briandorey/RaspberryPiBarcodeScanner/README.md

# Raspberry Pi Zero W Barcode Scanner
Raspberry Pi Zero W based barcode scanner files for http://www.briandorey.com/post/Raspberry-Pi-Zero-Handheld-Barcode-Scanner-Part-3
