briandorey/RaspberryPiBarcodeScanner/front lens.dxf

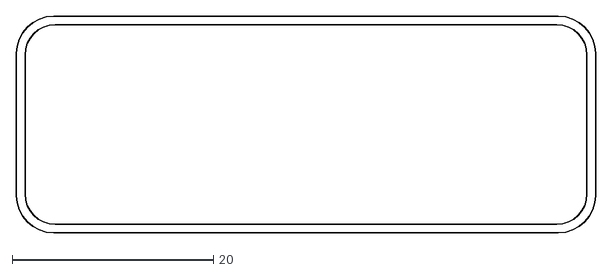
[picture p1: CAD file, 2017-06-02]
front lens.dxf
57.5 x 21.5
