briandorey/RaspberryPiBarcodeScanner/Interface-Board.pdf

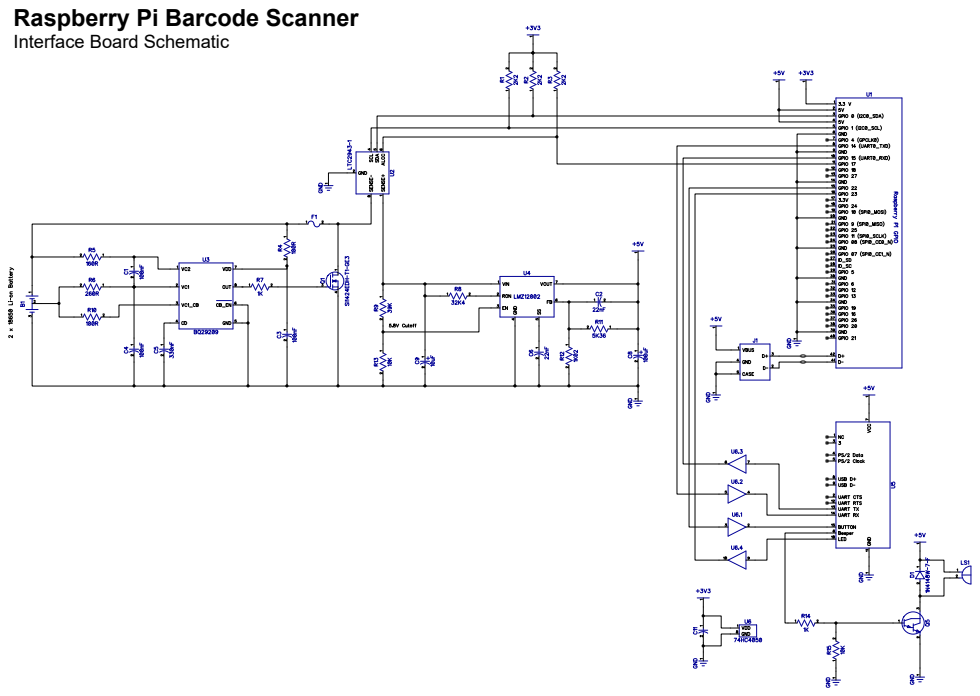
[picture p2: page 1]

Raspberry Pi Barcode Scanner
Interface Board Schematic
