briandorey/RaspberryPiBarcodeScanner/Software-Flowchart.pdf

# Raspberry Pi Barcode Scanner

# Software Flow

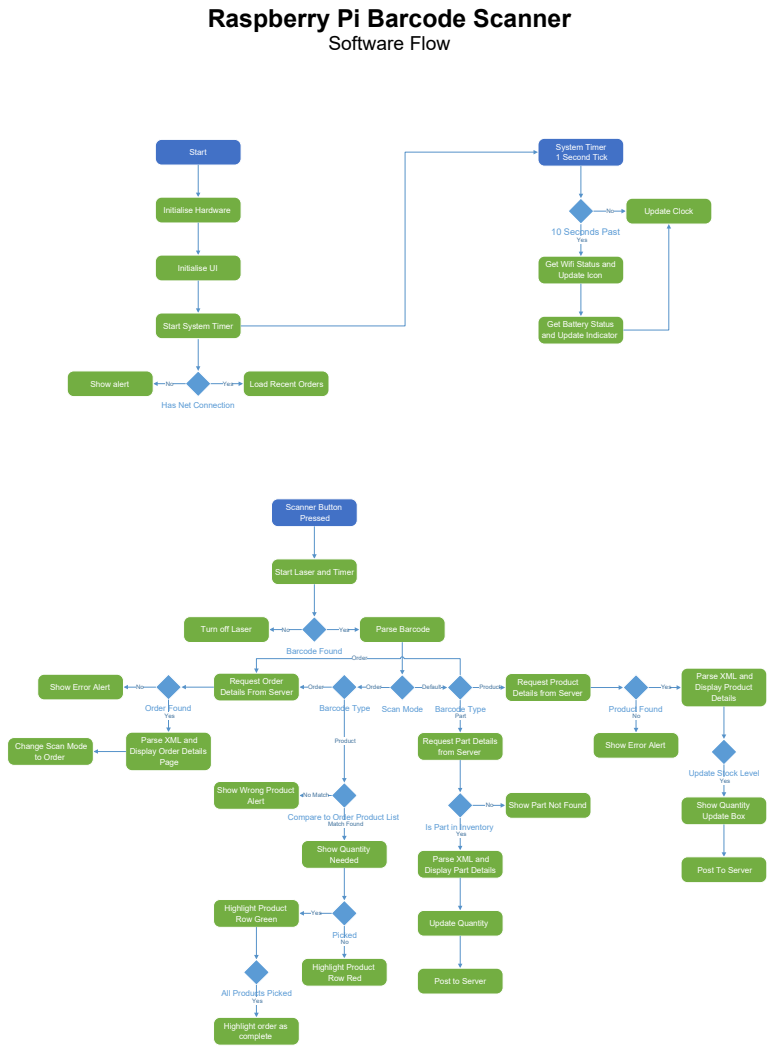
[picture p3: page 1]
Start; Initialise Hardware; Initialise UI; Show alert; Yes; Load Recent Orders; Scanner Button Pressed; Barcode Found; Turn off Laser; Parse Barcode; Barcode Type; Order Found; Show Error Alert; Scan Mode; Show Quantity Needed; Picked No; Highlight Product Row Red; Order; Product; Default; Part; Update Quantity; Show Part Not Found; Show Quantity Update Box; System Timer 1 Second Tick; 10 Seconds Past; Update Clock

Get Wifi Status and
Update Icon

Start System Timer

Get Battery Status
and Update Indicator

Has Net Connection

Start Laser and Timer

Parse XML and
Display Product
Details

Order Request Order
Details From Server

Request Product
Details from Server

Product Found No

Display Order Details
Page

Request Part Details
from Server

Show Error Alert

Change Scan Mode
to Order

Update Stock Level Yes

No Match Show Wrong Product
Alert

Compare to Order Product List Match Found

Is Part in Inventory Yes

Display Part Details

Post To Server

Yes Highlight Product
Row Green

Post to Server

All Products Picked Yes

Highlight order as
complete
