briandorey/RaspberryPiBarcodeScanner/(list of files, drawings)

Other design files:
Interface-Board.dch
Interface-Board.dip
