briandorey/RaspberryPiBarcodeScanner/(threads)

Thread 1 (2017-08-12):

Gerber

Austinthemighty, 2017-08-12:
Can you export the PCB as a Gerber file?

briandorey, 2017-08-13:
I have added the gerber files to the repo

Austinthemighty, 2017-08-13:
thank you

Austinthemighty, 2017-08-13:
also is there a BOM available

briandorey, 2017-08-14:
I have added the BOM as a csv file to the repo

Austinthemighty, 2017-08-21:
Thanks

Thread 2 (2017-08-14):

BOM

Austinthemighty, 2017-08-14:
Is there a BOM available also do you have 4-5 boards that you are willing to sell

briandorey, 2017-08-14:
I have added the bom as a csv file to the repo. I am sorry but I dont have any of the PCB boards to sell.

Closed 2017-08-14.

Thread 3 (2017-10-06):

Enclosure.stl

Austinthemighty, 2017-10-06:
here the enclosure that has been split up into 3 parts for easier printing and has been repaired.  when the enclosure was in one file it made it hard to print and was a lot more to get printed, but now it should be easier to print and a lot cheaper.

[Enclosure.zip](https://github.com/briandorey/RaspberryPiBarcodeScanner/files/1361643/Enclosure.zip)

nmouadili, 2020-03-25:
Hi Mr Austin , is it possible de to send me step file , thanks

Austinthemighty, 2020-06-03:
sadly I don't know how to convert it to a step file, but its saved as a STL in the zip file.
